whatnick/tt-ctvt-energy-dsp/docs/info.md

## How it works

CTVT Energy DSP controls an ADS131M02 on the Whatnick CTVT PMOD. When `DRDYn`
falls, the SPI master clocks a 72-bit response frame into the ASIC: one 24-bit
status word followed by signed 24-bit voltage and current samples.
The ASIC supplies the PMOD's `CLK_HOST` and `RESETn` signals. The bootstrap
implementation uses the ADC reset configuration and sends NULL command words;
explicit register configuration and CRC validation are the next acquisition
features.

The current implementation applies saturating offset correction and
accumulates five raw moments over 256 simultaneous samples:

- voltage and current sums for DC-offset estimation;
- voltage squared and current squared for RMS;
- voltage multiplied by current for active power.

At the end of each window, all accumulators are copied to a stable snapshot,
`SNAPSHOT_SEQ` increments, and `IRQn` remains low until `IRQ_ACK` is asserted.
A serialized signed multiplier and shared adder perform the arithmetic. A
second SPI interface lets a host read each result in a stable 64-bit wire
format. The core also calculates integer voltage/current RMS, window-average
active power, and cumulative signed active energy.

The planned processing stages add gain and fractional phase compensation,
reactive/apparent energy, power factor, frequency, phase angle,
sag/swell/overcurrent events, and selected harmonics using a serialized
Goertzel engine.

## How to test

Plug the CTVT PMOD into the bidirectional connector. Its standard Pmod SPI
ordering maps directly to `uio[0:3]`, with DRDYn, RESETn and CLK_HOST on
`uio[4:6]`. After reset, confirm that the ADS131M02 emits its default 72-bit
status/channel-0/channel-1 frame.

Use host SPI mode 0 at no more than 1 MHz. Send an 8-bit register address
MSB-first, then clock 64 additional bits to receive the selected value. Read
`SNAPSHOT_SEQ` before and after a group of result registers to confirm a
coherent window. Assert `IRQ_ACK` for at least one ASIC clock to release
`IRQn`.

For simulation:

```sh
cd test
python3 -m pip install -r requirements.txt
make -B
```

## External hardware

- [Whatnick CTVT PMOD](https://github.com/whatnick/ctvt-pmod)
- TI ADS131M02 dual simultaneous-sampling 24-bit ADC
- SPI host controller
