whatnick/tt-ctvt-energy-dsp/src/adc_spi_capture.v

/*
 * Copyright (c) 2026 Tisham Dhar
 * SPDX-License-Identifier: Apache-2.0
 */

`default_nettype none

module adc_spi_capture #(
    parameter integer CLK_DIV = 4,
    parameter integer ADC_MCLK_DIV = 2,
    parameter integer RESET_CYCLES = 4096
) (
    input  wire               clk,
    input  wire               rst_n,
    input  wire               adc_drdy_n,
    input  wire               adc_dout,
    output reg                adc_cs_n,
    output reg                adc_sclk,
    output wire               adc_din,
    output reg                adc_reset_n,
    output reg                adc_mclk,
    output reg                sample_valid,
    output reg  [23:0]        status_word,
    output reg  signed [23:0] voltage_sample,
    output reg  signed [23:0] current_sample,
    output reg  [31:0]        frame_count,
    output reg  [31:0]        overrun_count,
    output wire [3:0]         diagnostics
);

  localparam integer DIV_WIDTH = $clog2(CLK_DIV);
  localparam integer MCLK_DIV_WIDTH =
      (ADC_MCLK_DIV <= 1) ? 1 : $clog2(ADC_MCLK_DIV);
  localparam integer RESET_COUNT_WIDTH =
      (RESET_CYCLES <= 1) ? 1 : $clog2(RESET_CYCLES + 1);
  localparam integer DIV_LIMIT = CLK_DIV - 1;
  localparam integer MCLK_DIV_LIMIT = ADC_MCLK_DIV - 1;
  localparam integer RESET_COUNT_LIMIT = RESET_CYCLES - 1;

  reg [DIV_WIDTH-1:0] divider;
  reg [MCLK_DIV_WIDTH-1:0] mclk_divider;
  reg [RESET_COUNT_WIDTH-1:0] reset_counter;
  reg [6:0] bit_count;
  reg [71:0] shift_register;
  reg active;
  reg finishing;
  reg armed;
  reg adc_drdy_delayed;

  wire [71:0] shifted_frame = {shift_register[70:0], adc_dout};
  wire adc_drdy_falling = adc_drdy_delayed && !adc_drdy_n;
  assign adc_din = 1'b0;
  assign diagnostics = {frame_count != 0, active, armed, adc_reset_n};

  always @(posedge clk) begin
    if (!rst_n) begin
      adc_reset_n <= 1'b0;
      adc_mclk <= 1'b0;
      mclk_divider <= {MCLK_DIV_WIDTH{1'b0}};
      reset_counter <= {RESET_COUNT_WIDTH{1'b0}};
      adc_cs_n <= 1'b1;
      adc_sclk <= 1'b0;
      sample_valid <= 1'b0;
      status_word <= 24'b0;
      voltage_sample <= 24'sd0;
      current_sample <= 24'sd0;
      divider <= {DIV_WIDTH{1'b0}};
      bit_count <= 7'd0;
      shift_register <= 72'b0;
      active <= 1'b0;
      finishing <= 1'b0;
      armed <= 1'b0;
      adc_drdy_delayed <= 1'b1;
      frame_count <= 32'b0;
      overrun_count <= 32'b0;
    end else begin
      sample_valid <= 1'b0;
      adc_drdy_delayed <= adc_drdy_n;

      if (active && adc_drdy_falling)
        overrun_count <= overrun_count + 1'b1;

      if (mclk_divider == MCLK_DIV_LIMIT[MCLK_DIV_WIDTH-1:0]) begin
        mclk_divider <= {MCLK_DIV_WIDTH{1'b0}};
        adc_mclk <= ~adc_mclk;
      end else begin
        mclk_divider <= mclk_divider + 1'b1;
      end

      if (!adc_reset_n) begin
        adc_cs_n <= 1'b1;
        adc_sclk <= 1'b0;
        divider <= {DIV_WIDTH{1'b0}};
        active <= 1'b0;
        finishing <= 1'b0;
        armed <= 1'b0;
        if (reset_counter == RESET_COUNT_LIMIT[RESET_COUNT_WIDTH-1:0]) begin
          adc_reset_n <= 1'b1;
        end else begin
          reset_counter <= reset_counter + 1'b1;
        end
      end else if (!active) begin
        adc_sclk <= 1'b0;
        adc_cs_n <= 1'b1;
        divider <= {DIV_WIDTH{1'b0}};
        if (adc_drdy_n)
          armed <= 1'b1;
        if (armed && !adc_drdy_n) begin
          active <= 1'b1;
          armed <= 1'b0;
          adc_cs_n <= 1'b0;
          bit_count <= 7'd0;
          shift_register <= 72'b0;
          finishing <= 1'b0;
        end
      end else if (divider == DIV_LIMIT[DIV_WIDTH-1:0]) begin
        divider <= {DIV_WIDTH{1'b0}};
        if (!adc_sclk) begin
          adc_sclk <= 1'b1;
          shift_register <= shifted_frame;
          if (bit_count == 7'd71) begin
            status_word <= shifted_frame[71:48];
            voltage_sample <= shifted_frame[47:24];
            current_sample <= shifted_frame[23:0];
            finishing <= 1'b1;
          end else begin
            bit_count <= bit_count + 1'b1;
          end
        end else begin
          adc_sclk <= 1'b0;
          if (finishing) begin
            adc_cs_n <= 1'b1;
            active <= 1'b0;
            finishing <= 1'b0;
            sample_valid <= 1'b1;
            frame_count <= frame_count + 1'b1;
          end
        end
      end else begin
        divider <= divider + 1'b1;
      end
    end
  end

endmodule

`default_nettype wire
