whatnick/tt-ctvt-energy-dsp/(commit log)

2026-09-20 Start CTVT Tiny Tapeout energy DSP
    Add ADS131M02 SPI capture, a serialized metrology MAC, coherent measurement snapshots, host SPI readout, interrupt handshake, cocotb coverage, and the staged path toward RMS, energy, events, and Goertzel harmonic analysis.
2026-09-20 Keep cocotb checks gate-level compatible
    Avoid hierarchy-dependent debug access that is unavailable after synthesis while retaining all observable SPI and metrology assertions.
    [test.py]
2026-09-21 Add RMS power and energy processing
    Convert coherent raw moments into integer voltage/current RMS, window-average active power, cumulative signed active energy, and processed-measurement snapshots using a reusable serial square-root unit. Extend SPI registers, documentation, resource estimates, and multi-window golden tests.
2026-09-21 Add writable ADC offset calibration
    Synchronize host SPI into the core clock domain and add signed per-channel offset registers with readback and saturating 24-bit correction before accumulation. Cover calibrated measurements and both saturation limits in cocotb, and document protocol timing and updated FPGA utilization.
    [host_spi_readout.v, project.v, test.py]
2026-09-24 Optimize serialized metrology datapath
    Apply Joel Stanley's utilization recommendations with portable serial arithmetic, right-sized window storage, shared adders, synchronous reset, reproducible FabricFox reporting, and an attributed design review. Preserve the 64-bit cumulative energy counter and external SPI register format.
    [adc_spi_capture.v, energy_accumulator.v, host_spi_readout.v, integer_sqrt.v, metering_postprocess.v, project.v, serial_multiplier.v]
2026-10-10 Integrate GF180 metrology hardware flow
    Add direct CTVT PMOD acquisition, atomic host SPI, GF180 physical constraints and repair tuning, validated FabricFox and gate-level flows, implementation roadmaps, and reproducible signoff layout visuals.
2026-11-08 Add ADC bring-up diagnostics
    Expose completed-frame, overrun, and acquisition-state diagnostics through the host register interface, extend cocotb coverage, and document manufactured PMOD commissioning through FPGA-to-silicon comparison.
2026-11-08 Correct idle acquisition diagnostic state
    Account for the capture-armed bit remaining set while DRDYn is high between completed ADC frames.
